Jason-Pei-hub/4D-System/README.md

# 这是一份保密的工程
这只是一个本科生的毕设罢了......

所以我并不打算写readme

# 谢谢！
