Jason-Pei-hub/4D-System/Project_Docs/模拟事件相机.md

# 模拟事件相机 (Simulated Event Camera) 物理建模与技术文档

> 效果演示：



## 1. 理论背景：VID2E 模型与 DVS 原理

本算法深度参考了 CVPR 2020 经典论文 **《VID2E: From Videos to Realistic Events with Learned Data Augmentation》**。

**核心差异：**
传统的“帧差法”仅仅是简单的像素相减（$I_t - I_{t-1}$），这无法模拟真实事件相机（DVS）的物理特性。真实的 DVS 像素是对**光强的对数变化率**产生响应，从而具备超高的动态范围（HDR）和对光照变化的鲁棒性。

---

## 2. 数学物理模型与通俗解释

### A. 对数变换 (Log Transformation)
在处理每一帧图像时，首先将亮度信号映射到对数空间：

$$
L(u, t) = \ln(I(u, t) + \epsilon)
$$

* **$I(u, t)$**：像素点 $u$ 在时间 $t$ 的原始灰度值（归一化到 0.0~1.0）。
* **$\epsilon$ (Noise Floor)**：取值 **0.01**。
    * 这就像人眼的“底噪”。如果没有它，在全黑环境下（$I=0$），数学上 $\ln(0)$ 会变成负无穷大导致程序崩溃。它同时也过滤了传感器在极暗处的细微杂波。
* **物理意义 (韦伯定律)**：人眼和事件相机对光线的感知是非线性的。
    * **暗处**：手电筒稍微晃一下，你会觉得很刺眼（变化被放大）。
    * **亮处**：多开一盏灯，你可能觉得没区别（变化被压缩）。
    * 对数变换完美模拟了这种“暗处灵敏、亮处抗饱和”的特性。

### B. 临时对比度检测 (Temporal Contrast Detection)
计算连续两帧之间对数亮度的差值：

$$
\Delta L = L(u, t) - L(u, t-\Delta t)
$$

* **解释**：它不关心绝对亮度是多少，只关心亮度变化的“比例”。
    * 例如：亮度从 1 变成 2，和从 10 变成 20，它们的对数差值 $\Delta L$ 是一样的（都是 $\ln 2$）。这保证了无论在室内还是室外，物体的轮廓事件都是一致的。

### C. 事件极性触发判定 (Polarity Thresholding)
这是事件相机最核心的“异步脉冲”生成逻辑：

$$
e = \begin{cases} 
+1, & \text{if } \Delta L > C \quad (\text{ON Event}) \\ 
-1, & \text{if } \Delta L < -C \quad (\text{OFF Event}) \\ 
0, & \text{otherwise} 
\end{cases}
$$

* **$C$ (Contrast Threshold)**：对比度阈值。
    * **解释**：这是相机的“阈值”或“定力”。只有亮度变化的比例超过了这个值，像素才会“喊一声”（发送脉冲）。
    * 如果 $C$ 设太小，画面全是杂点（太敏感）；如果 $C$ 设太大，画面完全不动（太迟钝）。
    * **ON Event (+1)**：物体边缘移入或光照增强，画面呈现白色。
    * **OFF Event (-1)**：物体边缘移出或光照减弱，画面呈现黑色。

---

## 3. 代码实现核心逻辑 (C++)
在 `SimulatedEvent.cpp` 中，我们利用 OpenCV 的矩阵运算（SIMD加速）实现了上述物理过程，确保在 **210fps** 甚至 **420fps** 下依然能实时处理。

```cpp
cv::Mat SimulatedEvent::processFrame(const cv::Mat& gray_frame) {
    // 1. 图像归一化与对数化
    cv::Mat current_f, current_log;
    // 将 0-255 映射到 0-1 浮点数
    gray_frame.convertTo(current_f, CV_32F, 1.0/255.0); 
    // 公式实现：L = ln(I + 0.01)
    cv::log(current_f + (float)noise_floor, current_log); 

    // 2. 初始化检查：如果是第一帧，记录后直接返回
    if (last_log_frame.empty() || last_log_frame.size() != gray_frame.size()) {
        current_log.copyTo(last_log_frame);
        return cv::Mat::zeros(gray_frame.size(), CV_8U) + 127; // 返回中性灰 (无事件状态)
    }

    // 3. 计算对数变化量：diff = L(t) - L(t-1)
    cv::Mat diff = current_log - last_log_frame;
    current_log.copyTo(last_log_frame); // 更新参考帧，为下一帧做准备

    // 4. 三值化物理量化：{0, 127, 255}
    // 建立一个背景为 127 (灰) 的画布
    cv::Mat event_map(gray_frame.size(), CV_8U, cv::Scalar(127)); 
    
    // 如果变化量 > 阈值，设为 255 (白，ON事件)
    event_map.setTo(255, diff > threshold); 
    // 如果变化量 < 负阈值，设为 0 (黑，OFF事件)
    event_map.setTo(0, diff < -threshold);  

    return event_map;
}

```

---

## 4. 技术优势记录

1. **物理真实性**：严格遵循事件相机的光电响应原理，生成的事件流可直接用于 4DGS 模型训练，提升物体边缘和运动轨迹的恢复精度。
2. **抗噪性能**：由于引入了对数域和  噪声底，系统对 **OV9281** 在高帧率下产生的像素热噪声具有天然的抑制作用。
3. **多场景适应**：
* **120FPS**：高分辨率模式，适合精细重建。
* **210FPS**：性能均衡模式，画面最丝滑。
* **420FPS**：极限捕捉模式，适合解算高速旋转物体的物理属性。
