Jason-Pei-hub/4D-System/Hardware/模型/毕设外壳_延长.stl

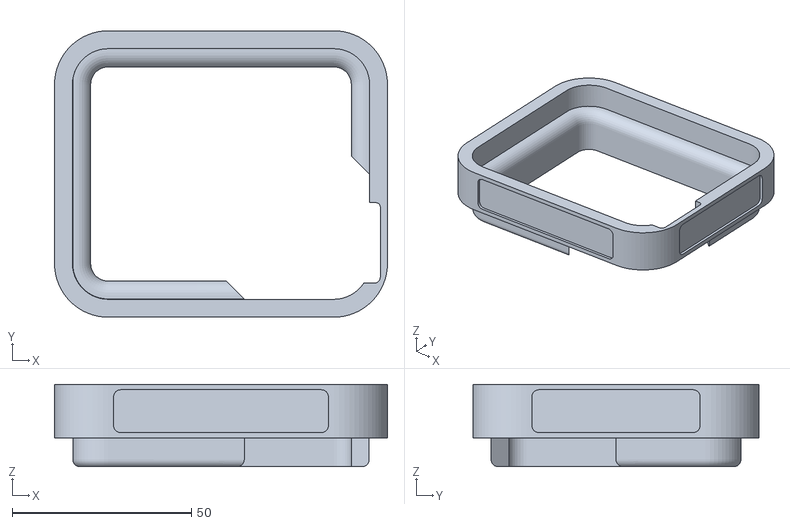
[picture p2: CAD file, 2026-01-21]
Hardware/模型/毕设外壳_延长.stl
93.0 x 80.0 x 23.0
