Jason-Pei-hub/4D-System/Hardware/模型/毕设外壳_前端.stl

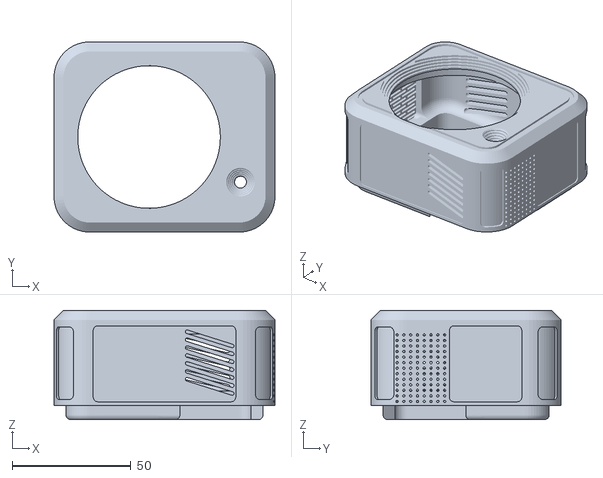
[picture p3: CAD file, 2026-01-21]
Hardware/模型/毕设外壳_前端.stl
93.0 x 80.0 x 46.0
