Jason-Pei-hub/4D-System/Hardware/模型/毕设外壳_后端.stl

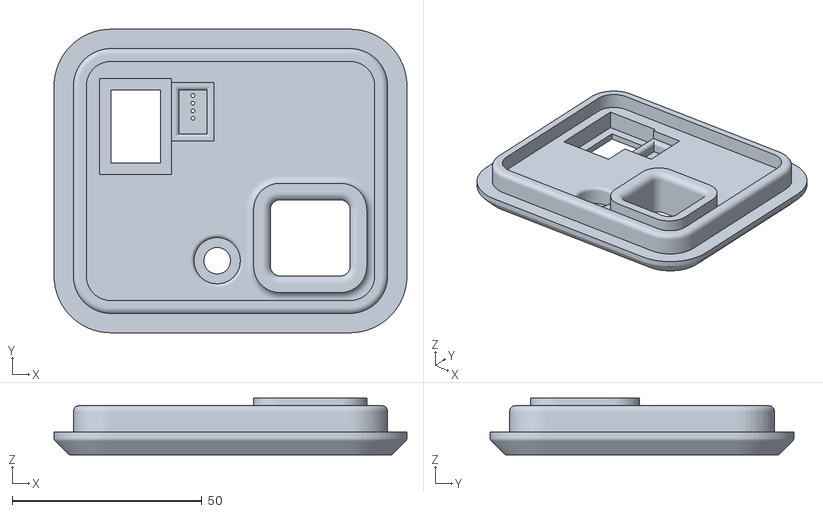
[picture p4: CAD file, 2026-01-12]
Hardware/模型/毕设外壳_后端.stl
93.0 x 80.0 x 15.0
