Jason-Pei-hub/4D-System/Hardware/模型/毕设外壳_摄像头架.stl

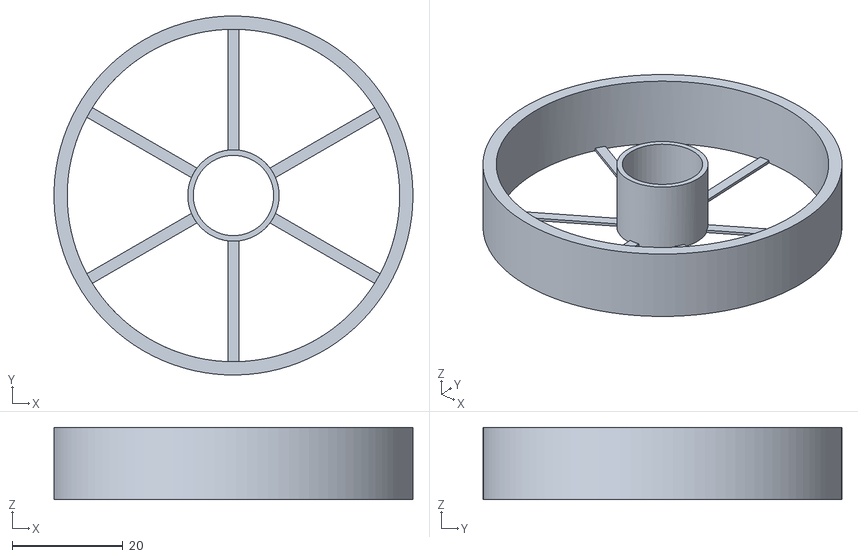
[picture p5: CAD file, 2026-01-12]
Hardware/模型/毕设外壳_摄像头架.stl
64.8 x 64.8 x 13.0
