Jason-Pei-hub/4D-System/Hardware/模型/毕设外壳_中间部分.stl

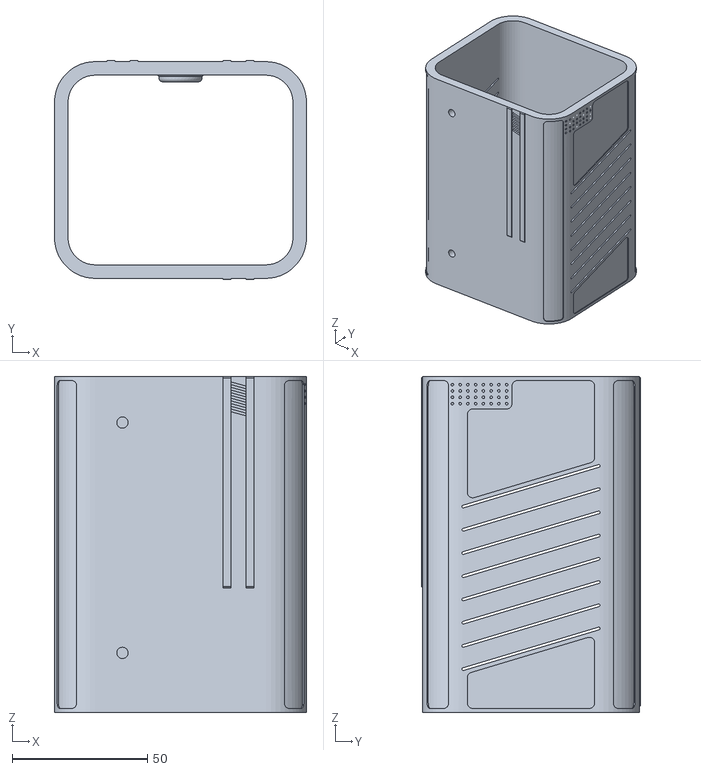
[picture p6: CAD file, 2026-01-12]
Hardware/模型/毕设外壳_中间部分.stl
93.0 x 81.0 x 124.0
