Jason-Pei-hub/4D-System/Hardware/模型/防滑贴.dxf

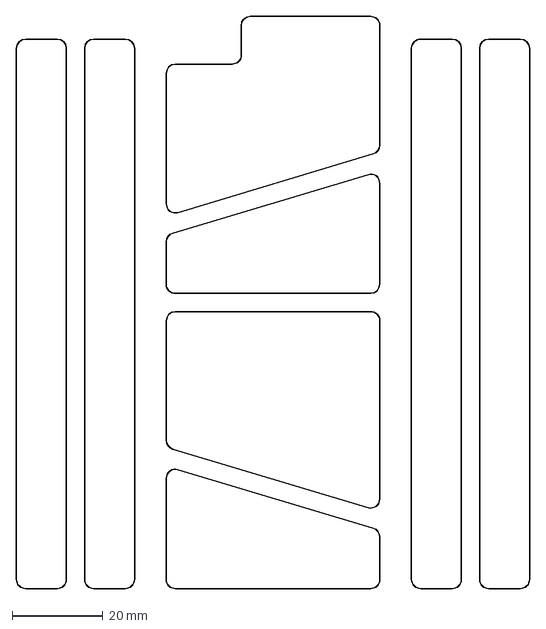
[picture p7: CAD file, 2026-01-12]
Hardware/模型/防滑贴.dxf
113.0 x 126.0 mm
