Jason-Pei-hub/4D-System/PC_Server_Python/debug_t.png

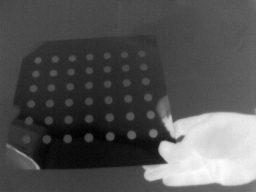
PC_Server_Python/debug_t.png
