Jason-Pei-hub/4D-System/(commit log)

2025-12-25 热成像相关sdk配置并测试成功（x64）
2025-12-26 精简sample.cpp中代码，删除无用定义并添加注释
2025-12-26 feat: 完成基于 v2e 论文的物理仿真算法，完成ov9812的驱动编写以及 120/210/420 FPS 切换
2025-12-28 成功在Linux环境下配置，热成像和120fpsov9281摄像头均可成功运行
2025-12-28 包含build目录和完整的SDK内容
2025-12-29 阶段视频演示效果更新
2025-12-29 树莓派拉取视频流开发记录
2025-12-29 增加阶段演示效果展示
2025-12-29 修复无法显示gif
2025-12-30 完成树莓派传输链路的搭建，修改底层逻辑，已经实现ov9281 120fps以及热成像全数据稳定传输
2025-12-30 更新传输功能的日志
2025-12-30 更新readme
2025-12-30 重新整理工程，添加PC服务端的数据接收功能，PC决定使用python
2026-01-12 思考接下来的方向，完成了设计和建模工作
    [毕设外壳_中间部分.stl, 毕设外壳_前端.stl, 毕设外壳_后端.stl, 毕设外壳_摄像头架.stl, 防滑贴.dxf]
2026-01-21 完成了ui编写，同时查阅了论文，确定未来方向，这几天在做硬件进度较慢
    [毕设外壳_前端.stl, 毕设外壳_延长.stl]
2026-01-25 完成了软件初步demo，初步实现数据对齐，录制演示视频
2026-01-27 为后续算法增加接口ui，测试完成，目前qt框架搭建完成
